nuntawat168/MOMIU-Embedded-System/README.md

# MOMIU-Embedded-System
This source is a embedded system part of Momiu robot project
https://ieeexplore.ieee.org/document/9795546/metrics#metrics
