nuntawat168/MOMIU-Embedded-System/! IMPORTANT - Release Document for Altium Designer.txt

Follow this procedure before releasing files. Confirm every action with your initials and date.
IF ANY CHANGES NEEDS TO BE DONE, START THE PROCEDURE FROM BEGINNING!

The procedure needs to be executed in order as defined here. Start from number 1
--------------------------------------------------------------------------------

1) Right Click on the project -> Compile PCB project
I confirm, the project compiles with no errors: 
Confirm [23-04-2021]

2) Run Design -> Update PCB Document
I confirm, there are no differences between Schematic and PCB: 
Confirm [23-04-2021]

3) Impedance
I confirm, I have updated and check track width/gap to match required impedance (e.g 55 OHMs): 
NA

4) Run Tools -> Polygon Pours -> Rebuild All
I confirm, all polygons have been repoured: 
Confirm [23-04-2021]

5) Run Tools -> Design Rule Check -> Run Design Rule Check
I confirm, I have checked Design Rule Output File:
Confirm [23-04-2021]

6) Gerber check
I confirm, I have copied and visually checked gerber files placed in \PCB Manufacturing\Gerber Output\
Confirm [23-04-2021]

7) Other files
I confirm, I have copied and checked files placed in subdirectories:
Confirm [23-04-2021]
