nuntawat168/MOMIU-Embedded-System/6 - Source Files/Media/Image-3D_PCB-INTERFACE-BOARD-MOMIU.png

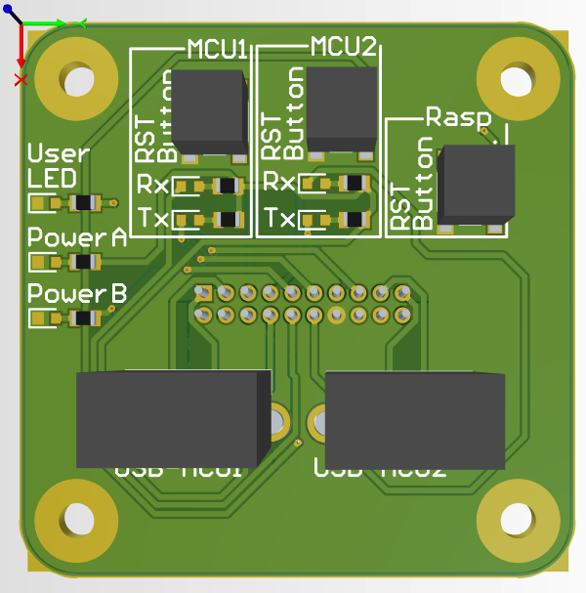
6 - Source Files/Media/Image-3D_PCB-INTERFACE-BOARD-MOMIU.png
