nuntawat168/MOMIU-Embedded-System/2 - Board Assembly/BOM Purchase_MOMIU-Circuit.xlsx

Sheet: Part List Report
 | Bil of Materials |  |  | BOM MOMIU Robot Circuit
 | Source Data From: | momiu_01.PrjPcb
 | Project: | momiu_01.PrjPcb
 | Variant: | None
 | Report Date: | 5/7/2021 | 9:30 PM
 | Print Date: | 2021-05-08 | 9:22:43
No. | Component | Description | Designator | Supplier | Quantity | Supplier Order Qty | Supplier Unit Price | Supplier Ext. Price | Supplier Currency | Supplier Stock | Supplier Part Number 1 | PhysicalPath | Mouser Price/Stock
1 | 20SVPF120M | Capacitor Polarised | C1, C3 | Mouser | 2 | 2 | 1.25 | 2.5 | USD | 14231 | 667-20SVPF120M | MAIN BOARD | https://www.mouser.co.uk/ProductDetail/Panasonic/20SVPF120M/?qs=OE1iw1LrrPFAGQZp2uLmXQ%3D%3D
2 | *EMVY160ADA471MHA0G | Capacitor Polarised | C2, C4 | Mouser | 2 | 2 | 0.7 | 1.4 | USD | 0 | 661-EMVY160ADA471MHA | MAIN BOARD | https://www.mouser.com/Search/Refine.aspx?Keyword=661-EMVY160ADA471MHA
 | **UWT1C471MNL1GS | Capacitor Polarised | C2, C5 | E-SOURCE | 2 | 2 | 0.17 | 0.34 | USD | 9,117 | 0289-0172-4 | MAIN BOARD | https://www.es.co.th/detail.asp?Prod=028901724
4 | C0805C104K5RAC7411 | Capacitor | C5, C6 | Mouser | 2 | 2 | 0.24 | 0.48 | USD | 32058 | 80-C0805C104K5RACLR | MAIN BOARD | https://www.mouser.co.uk/ProductDetail/KEMET/C0805C104K5RAC7411?qs=jbRM9o5BbzPcVXF0wW9AYg%3D%3D
5 | *PDS560-13 | Diode | D1, D2 | Mouser | 2 |  | 1.05 | 0 | USD | 0 | 621-PDS560-F | MAIN BOARD | https://www.mouser.co.uk/ProductDetail/Diodes-Incorporated/PDS560-13?qs=%2FNF5U5UGuWkl3I91y%252BsKBg%3D%3D
 | **PDS760-13 | Diode | D1, D2 | Mouser | 2 | 2 | 1.02 | 2.04 | USD | 48658 | 621-PDS760-F | MAIN BOARD | https://www.mouser.com/ProductDetail/Diodes-Incorporated/PDS760-13
7 | MMZ2012R600AT000 | Ferrite Beads 60 OHM 25% @100 MHz | FB1, FB2, FB3, FB4, FB5, FB6, FB7, FB8, FB9, FB10, FB11, FB12 | Mouser | 12 | 12 | 0.053 | 0.636 | USD | 18028 | 810-MMZ2012R600AT000 | INTERFACE BOARD, MAIN BOARD | https://www.mouser.com/ProductDetail/TDK/MMZ2012R600AT000
8 | LM2576HVS-5.0 | Integrated Circuit | IC1, IC2 | Mouser | 2 |  | 6.96 | 0 | USD | 3128 | 926-LM2576HVS5.0NOPB | MAIN BOARD | https://www.mouser.co.uk/ProductDetail/Texas-Instruments/LM2576HVS-50/?qs=X1J7HmVL2ZGtvFS7GBfMMQ%3D%3D
 | LM2576HVR-5.0 | Integrated Circuit | IC1, IC3 | E-SOURCE | 2 | 2 | 1.21 | 2.42 | USD | 59 | 0339-0011-4 | MAIN BOARD | https://www.es.co.th/detail.asp?Prod=033900114
10 | 22-03-5035 | Connector | J2, J3, J4, J5, J6, J7 | Mouser | 6 | 6 | 0.24 | 1.44 | USD | 18151 | 538-22-03-5035 | MAIN BOARD | https://www.mouser.co.uk/ProductDetail/Molex/22-03-5035?qs=VKrXD49J9Ep%252Bv2WwbOoiPA%3D%3D
11 | 22035045 | Connector | J8, J10, J11, J13, J20, J21 | Mouser | 6 | 6 | 0.26 | 1.56 | USD | 3587 | 538-22-03-5045 | MAIN BOARD | https://www.mouser.com/ProductDetail/Molex/22-03-5045
12 | PRT-14275 | Connector | J9 | Mouser | 1 | 1 | 0.95 | 0.95 | USD | 14 | 474-PRT-14275 | MAIN BOARD | https://www.mouser.co.uk/ProductDetail/SparkFun/PRT-14275/?qs=YCa%2FAAYMW01SLG%2FRsDUFug%3D%3D
13 | 87583-3010RPALF | Connector | J12, J14, J15 | Mouser | 3 | 3 | 0.94 | 2.82 | USD | 1604 | 649-87583-3010RPALF | MAIN BOARD | https://www.mouser.co.uk/ProductDetail/Amphenol-FCI/87583-3010RPALF/?qs=nBv%252BRDKgYU12SV7JkWVR7Q%3D%3D
14 | 957220-6002-AR | Connector | J16, J17 | Mouser | 2 |  | 2.66 | 0 | USD | 4778 | 517-957220-6002-AR | MAIN BOARD, INTERFACE BOARD | https://www.mouser.co.uk/ProductDetail/3M-Electronic-Solutions-Division/957220-6002-AR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
15 | GSB11121KEU | Connector | J18, J19 | Mouser | 2 | 2 | 0.7 | 1.4 | USD | 1676 | 523-GSB11121KEU | INTERFACE BOARD | https://www.mouser.com/ProductDetail/Amphenol-Commercial-Products/GSB11121KEU
16 | 22-03-5075 | Connector | J22, J23, J24, J25, J26 | Mouser | 5 | 5 | 0.35 | 1.75 | USD | 4330 | 538-22-03-5075 | MAIN BOARD | https://www.mouser.co.uk/ProductDetail/Molex/22-03-5075?qs=4hg9R9g9MDvXfItj0edHKA%3D%3D
17 | SRP2313AA-101M | Inductor | L1, L2 | Mouser | 2 | 2 | 7.8 | 15.6 | USD | 447 | 652-SRP2313AA-330M | MAIN BOARD | https://www.mouser.co.uk/ProductDetail/Bourns/SRP2313AA-101M?qs=gZXFycFWdANfITbqx%252BPtOw%3D%3D
18 | SML-D12Y8WT86C | LED | LED1, LED4 | Mouser | 2 | 2 | 0.31 | 0.62 | USD | 28848 | 755-SML-D12Y8WT86 | INTERFACE BOARD | https://www.mouser.co.uk/ProductDetail/ROHM-Semiconductor/SML-D12Y8WT86C?qs=HXFqYaX1Q2zmWm4VzJ%252BtnA%3D%3D
19 | SML-D12M8WT86C | LED | LED2, LED3 | Mouser | 2 | 2 | 0.31 | 0.62 | USD | 22557 | 755-SML-D12M8WT86 | INTERFACE BOARD | https://www.mouser.co.uk/ProductDetail/ROHM-Semiconductor/SML-D12M8WT86C?qs=HXFqYaX1Q2wmk6UmYQ4EIQ%3D%3D
20 | SML-D12U1WT86 | LED | LED5, LED6, LED7 | Mouser | 3 | 3 | 0.2 | 0.6 | USD | 183969 | 755-SML-D12U1WT86 | INTERFACE BOARD | https://www.mouser.co.uk/ProductDetail/ROHM-Semiconductor/SML-D12U1WT86?qs=M3jcYzEJUdEySuGkbjHEtQ%3D%3D
21 | CRCW080510K0JNEAC | Resistor | R1 | Mouser | 1 | 1 | 0.1 | 0.1 | USD | 76591 | 71-CRCW0805J-10K-E3 | MAIN BOARD | https://www.mouser.co.uk/ProductDetail/Vishay-Dale/CRCW080510K0JNEAC?qs=E3Y5ESvWgWO0MOXy5ngfMA%3D%3D
22 | CHP0805AFX-5600ELF | Resistor | R2, R3, R4, R5, R6, R7, R8 | Mouser | 7 | 7 | 0.47 | 3.29 | USD | 2315 | 652-CHP0805AFX-5600L | INTERFACE BOARD | https://www.mouser.co.uk/ProductDetail/Bourns/CHP0805AFX-5600ELF/?qs=GedFDFLaBXHiLkJv9wkGiw%3D%3D
23 | PTS645SK50JSMTR92_LFS | Switch | S1, S2, S3 | Mouser | 3 | 3 | 0.41 | 1.23 | USD | 17087 | 611-SK50JSMTR92LFS | INTERFACE BOARD | https://www.mouser.com/ProductDetail/CK/PTS645SK50JSMTR92-LFS
24 | SN74LS241N | Integrated Circuit | U1 | Mouser | 1 | 1 | 0.9 | 0.9 | USD | 809 | 595-SN74LS241N | MAIN BOARD | https://www.mouser.co.uk/ProductDetail/Texas-Instruments/SN74LS241N?qs=tJ5HNKWh3OV6ot2H0B4Gfg%3D%3D
25 | NUCLEO-F411RE | Microcomtroller | U2, U3 | Mouser | 2 |  | 13.55 | 0 | USD | 544 | 511-NUCLEO-F411RE | MAIN BOARD | https://www.mouser.com/ProductDetail/STMicroelectronics/NUCLEO-F411RE
26 | XT60-YELLOW | Power connector | J1 | Mouser | 1 | 2 | 1.5 | 3 | USD | 1006 | 474-PRT-10474 | MAIN BOARD | https://www.mouser.com/ProductDetail/SparkFun/PRT-10474?qs=WyAARYrbSnYJaRDMiD9g2w%3D%3D
24 | 50-37-5033 | Connector | None | Mouser | 6 | 6 | 0.34 | 2.04 | USD | 36349 | 538-50-37-5033 | None | https://www.mouser.com/ProductDetail/Molex/50-37-5033
25 | 50-37-5043 | Connector | None | Mouser | 6 | 6 | 0.37 | 2.22 | USD | 28900 | 538-50-37-5043 | None | https://www.mouser.com/ProductDetail/Molex/50-37-5043
26 | 50-37-5073 | Connector | None | Mouser | 5 | 5 | 0.2 | 1 | USD | 26658 | 538-50-37-5073 | None | https://www.mouser.com/ProductDetail/Molex/50-37-5073
27 | 08-70-1039 | Receptacle terminal | None | Mouser | 17 | 100 | 0.057 | 5.7 | USD | 6700 | 538-08-70-1039 | None | https://www.mouser.com/ProductDetail/Molex/08-70-1039-Cut-Strip?qs=Y0K5pK5Q%2FZG5wb5AnQMF0g%3D%3D
 |  |  |  |  |  |  |  | 56.656
Approved |  |  |  | Notes
 |  |  |  |  |  |  | 1 |  | pcs: | Total | 56.656 | USD
 |  |  |  |  |  |  |  |  |  | Price for 1pcs | 56.66 | USD

Sheet: Project Information
Project Full Path | D:\For Work\work year 4\year 4 term 1\thesis\Altium_ws\momiu_circuit_design\momiu_01\momiu_01.PrjPcb
Project Filename | momiu_01.PrjPcb
Variant Name | None
Data-Source Filename | momiu_01.PrjPcb
Data-Source Full Path | D:\For Work\work year 4\year 4 term 1\thesis\Altium_ws\momiu_circuit_design\momiu_01\momiu_01.PrjPcb
Title | BOM_MOMIU ROBOT-V1-PROJECT for Project [momiu_01.PrjPcb] (No PCB Document Selected)
Total Quantity | 71
Report Time | 9:30 PM
Report Date | 5/7/2021
Report Date & Tine | 5/7/2021 9:30 PM
Output Name | BOM_MOMIU ROBOT-V1-PROJECT
Output Type | BOM_PartType
Output Generator Name | BOM
Output Generator Description | Bill of Materials
