nuntawat168/MOMIU-Embedded-System/6 - Source Files/Templates/BOM Purchase_MOMIU-Ver.xlsx

Sheet: Part List Report
 | Bil of Materials |  |  | Field=Title
 | Source Data From: | Field=DataSourceFileName
 | Project: | Field=ProjectFileName
 | Variant: | Field=VariantName
 | Report Date: | Field=ReportDate | Field=ReportTime
 | Print Date: | 2021-05-07 | 21:28:43
# | Column=LibRef | Column=Description | Column=Designator | Column=Quantity | Column=Supplier 1 | Column=Supplier Unit Price 1 | Column=Supplier Currency 1 | Column=Supplier Stock 1 | Column=Supplier Packaging 1 | Column=Supplier Part Number 1 | Column=Mouser Price/Stock | Column=PhysicalPath | Column=Supplier Currency 1
1
2
3
 |  |  |  |  |  | 0 |  |  | 0 |  |  | 0
Approved |  |  |  | Notes
 |  |  |  |  |  | Field=ProductionQuantity | pcs: | Total |  | 0 |  | Field=Currency
 |  |  |  |  |  |  |  | Price for 1pcs |  | #VALUE! |  | Field=Currency

Sheet: Project Information
Project Full Path | Field=ProjectFullPath
Project Filename | Field=ProjectFileName
Variant Name | Field=VariantName
Data-Source Filename | Field=DataSourceFileName
Data-Source Full Path | Field=DataSourceFullPath
Title | Field=Title
Total Quantity | Field=TotalQuantity
Report Time | Field=ReportTime
Report Date | Field=ReportDate
Report Date & Tine | Field=ReportDateTime
Output Name | Field=OutputName
Output Type | Field=OutputType
Output Generator Name | Field=GeneratorName
Output Generator Description | Field=GeneratorDescription
