nuntawat168/MOMIU-Embedded-System/4 - 3D/3D-STEP_PCB_INTERFACE-BOARD-MOMIU.step

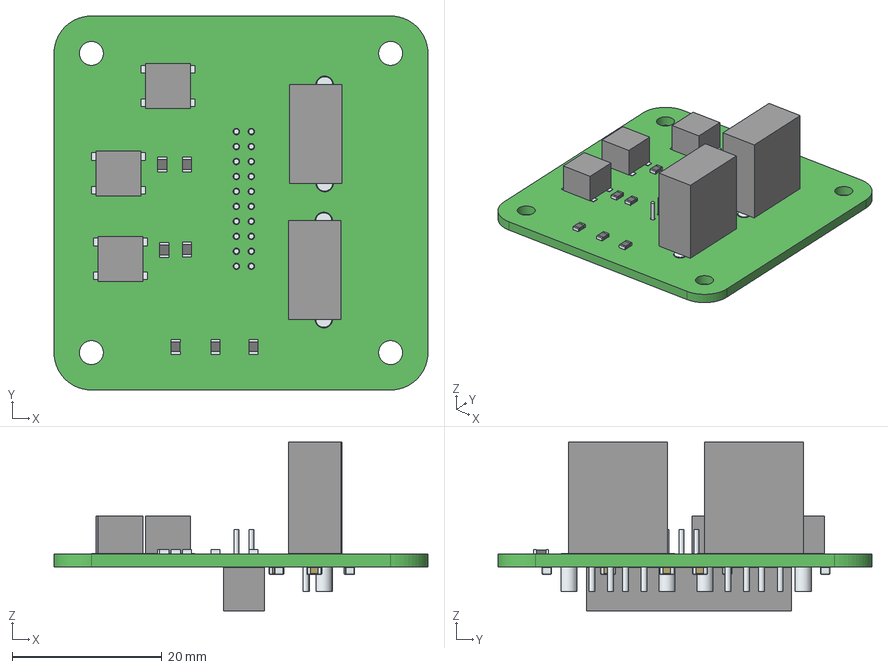
[picture p3: CAD file, 2021-12-10]
4 - 3D/3D-STEP_PCB_INTERFACE-BOARD-MOMIU.step
50.0 x 50.0 x 22.6 mm
term1 x 7
term2 x 7
Pins x 3
Leads x 32
