nuntawat168/MOMIU-Embedded-System/5 - Schematic/MOMIU ROBOT-V1_Schematic.PDF

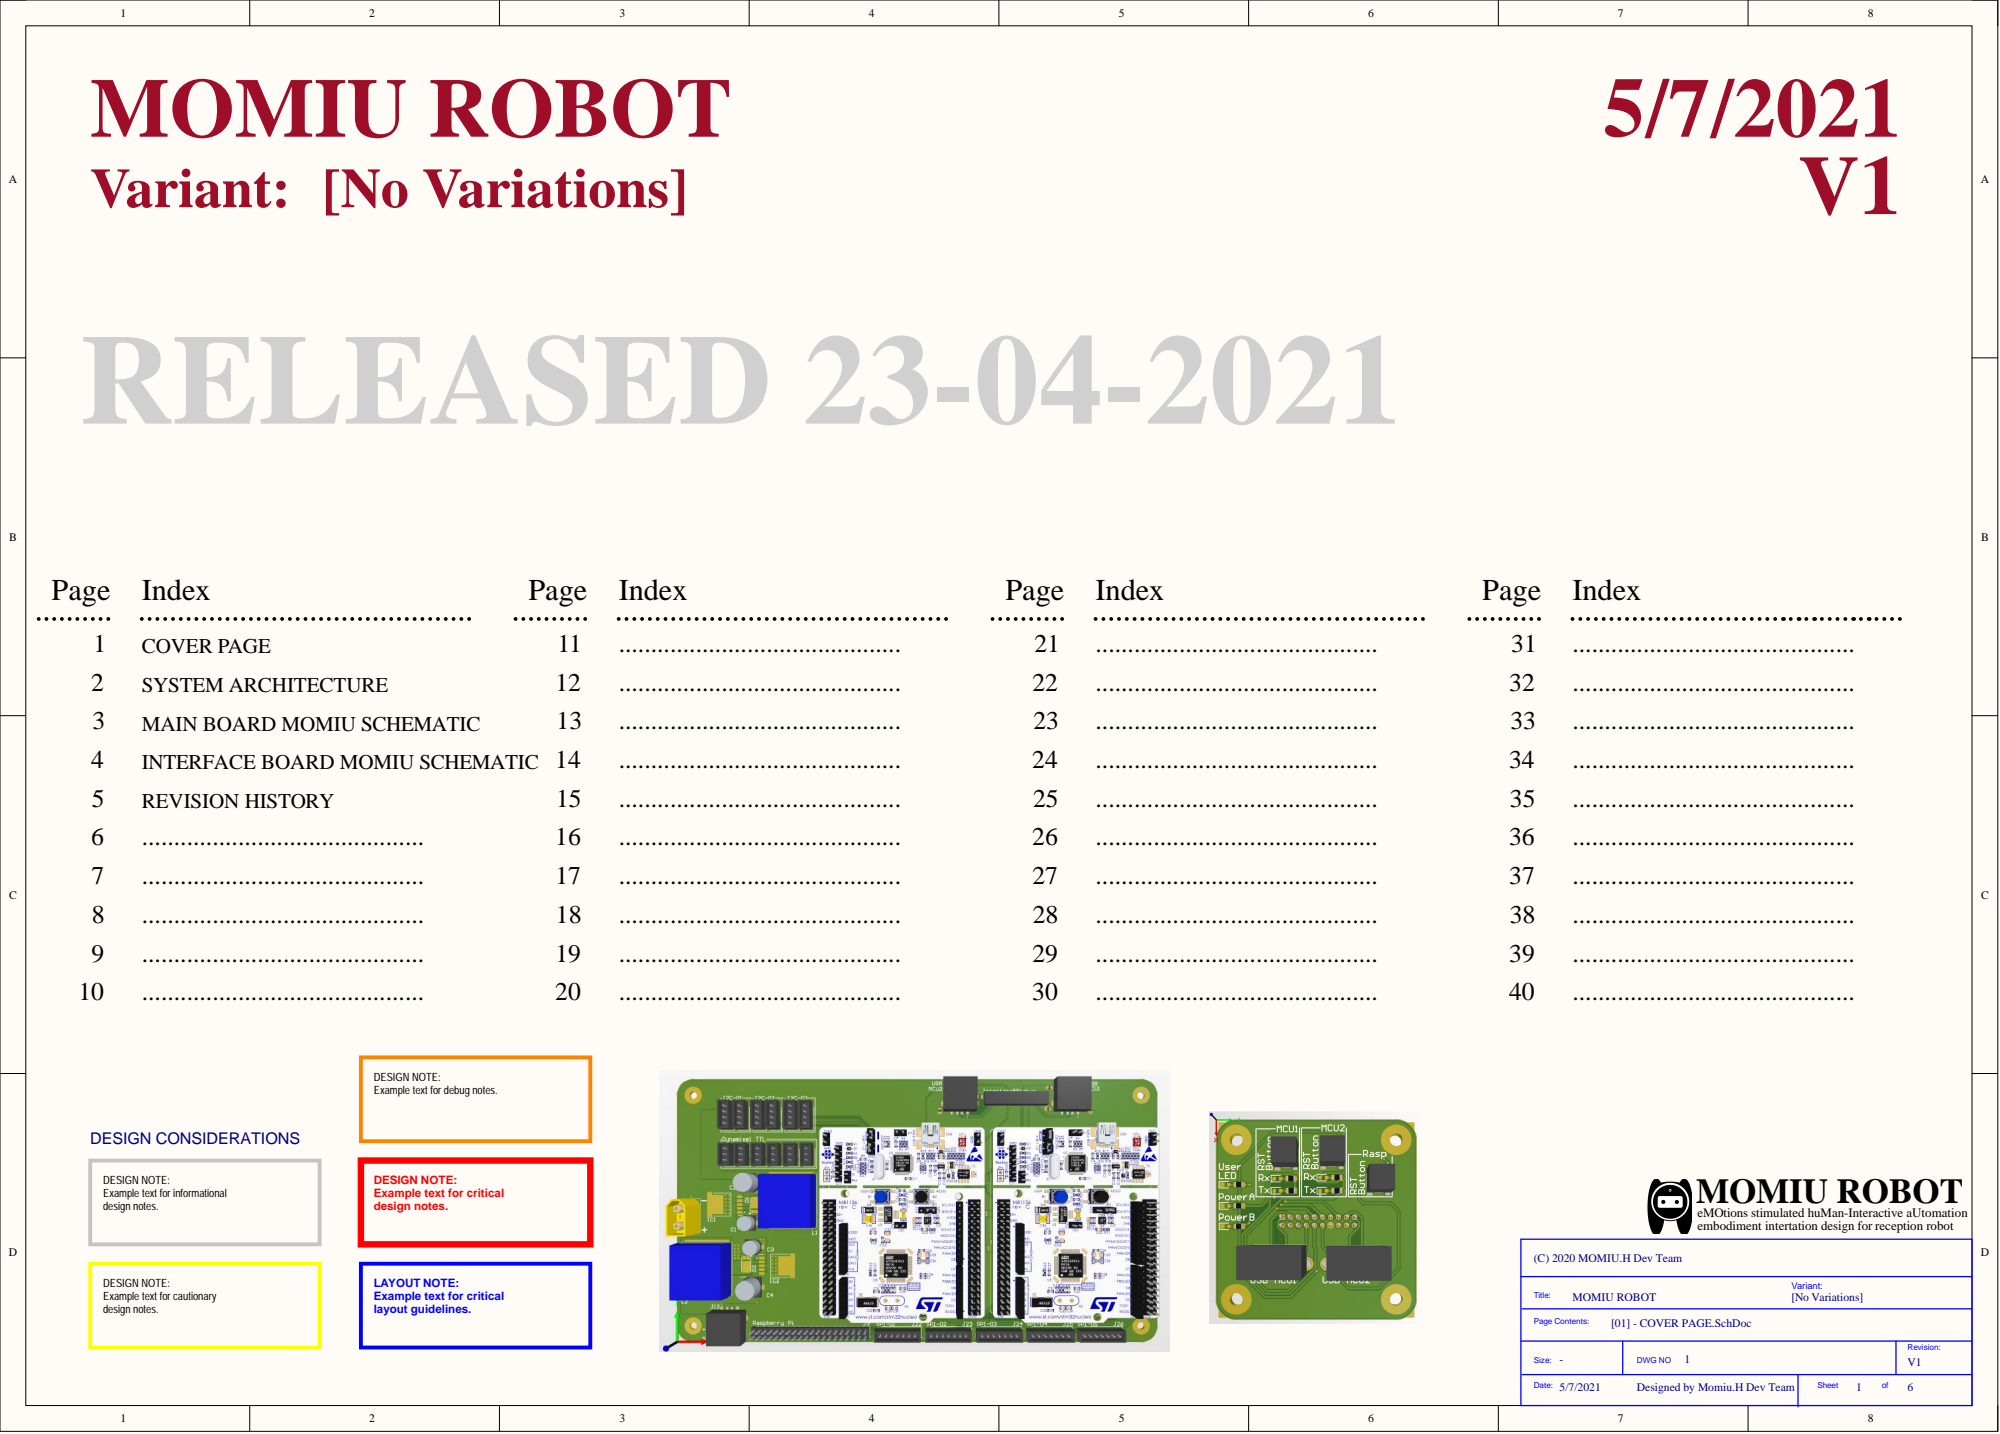
[picture p4: page 1]

DESIGN NOTE:
Example text for debug notes.

Example text for informational
design notes.

Example text for critical

eMOtions stimulated huMan-Interactive aUtomation
embodiment intertation design for reception robot

Example text for cautionary

LAYOUT NOTE:
layout guidelines.

Size: - 1 | DWG NO | Revision: V1

Date: Designed by Momiu.H Dev Team | Sheet of

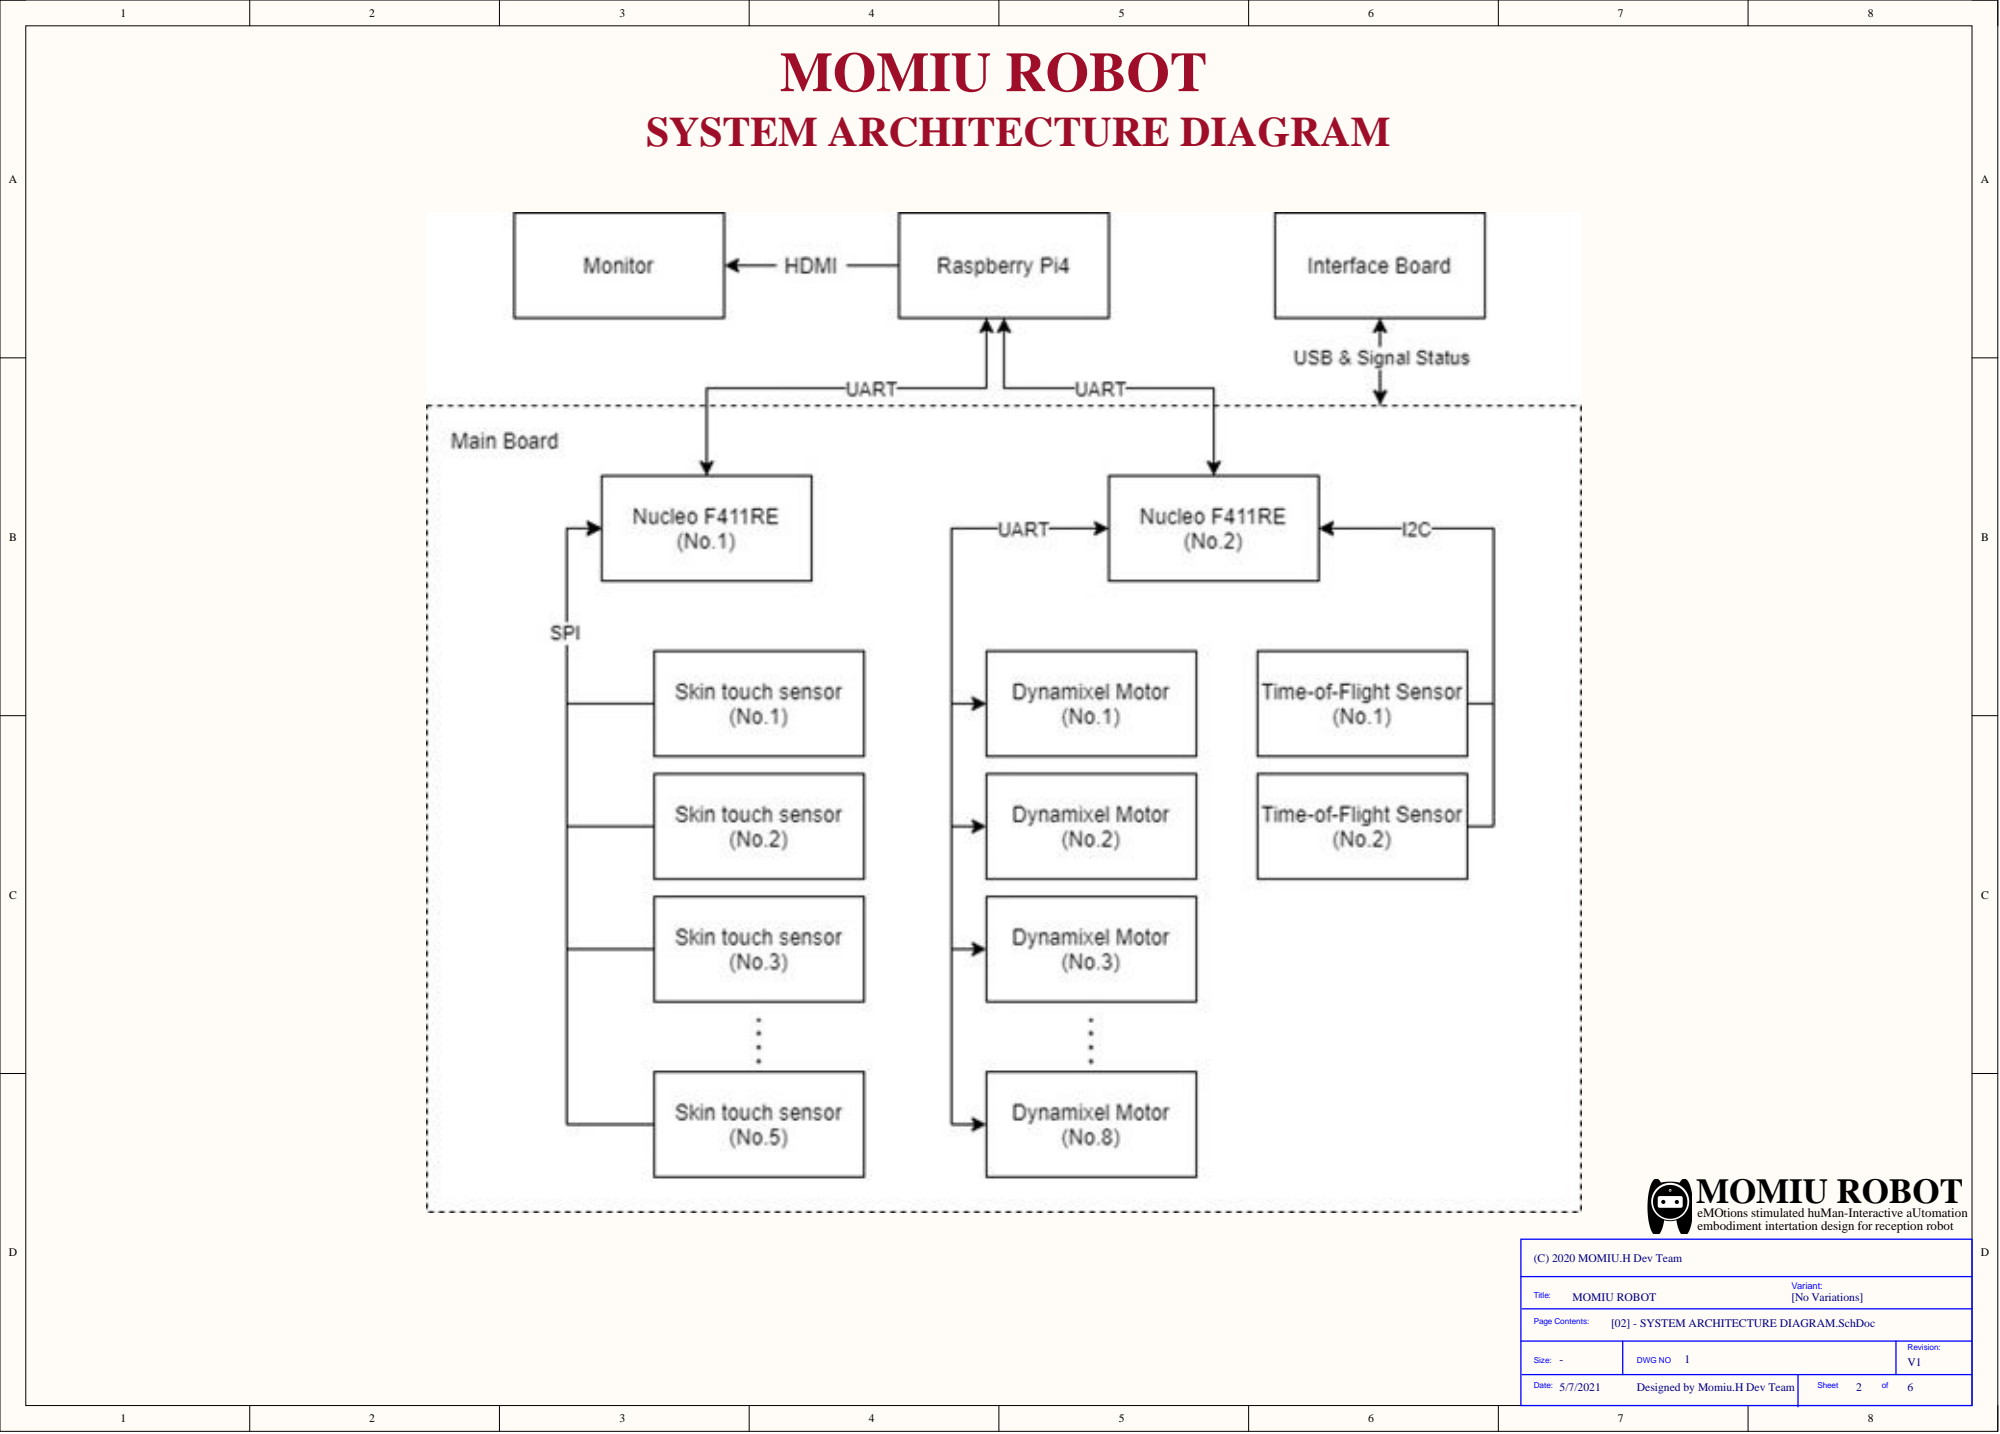
[picture p5: page 2]

eMOtions stimulated huMan-Interactive aUtomation
embodiment intertation design for reception robot

[02] - SYSTEM ARCHITECTURE DIAGRAM.SchDoc

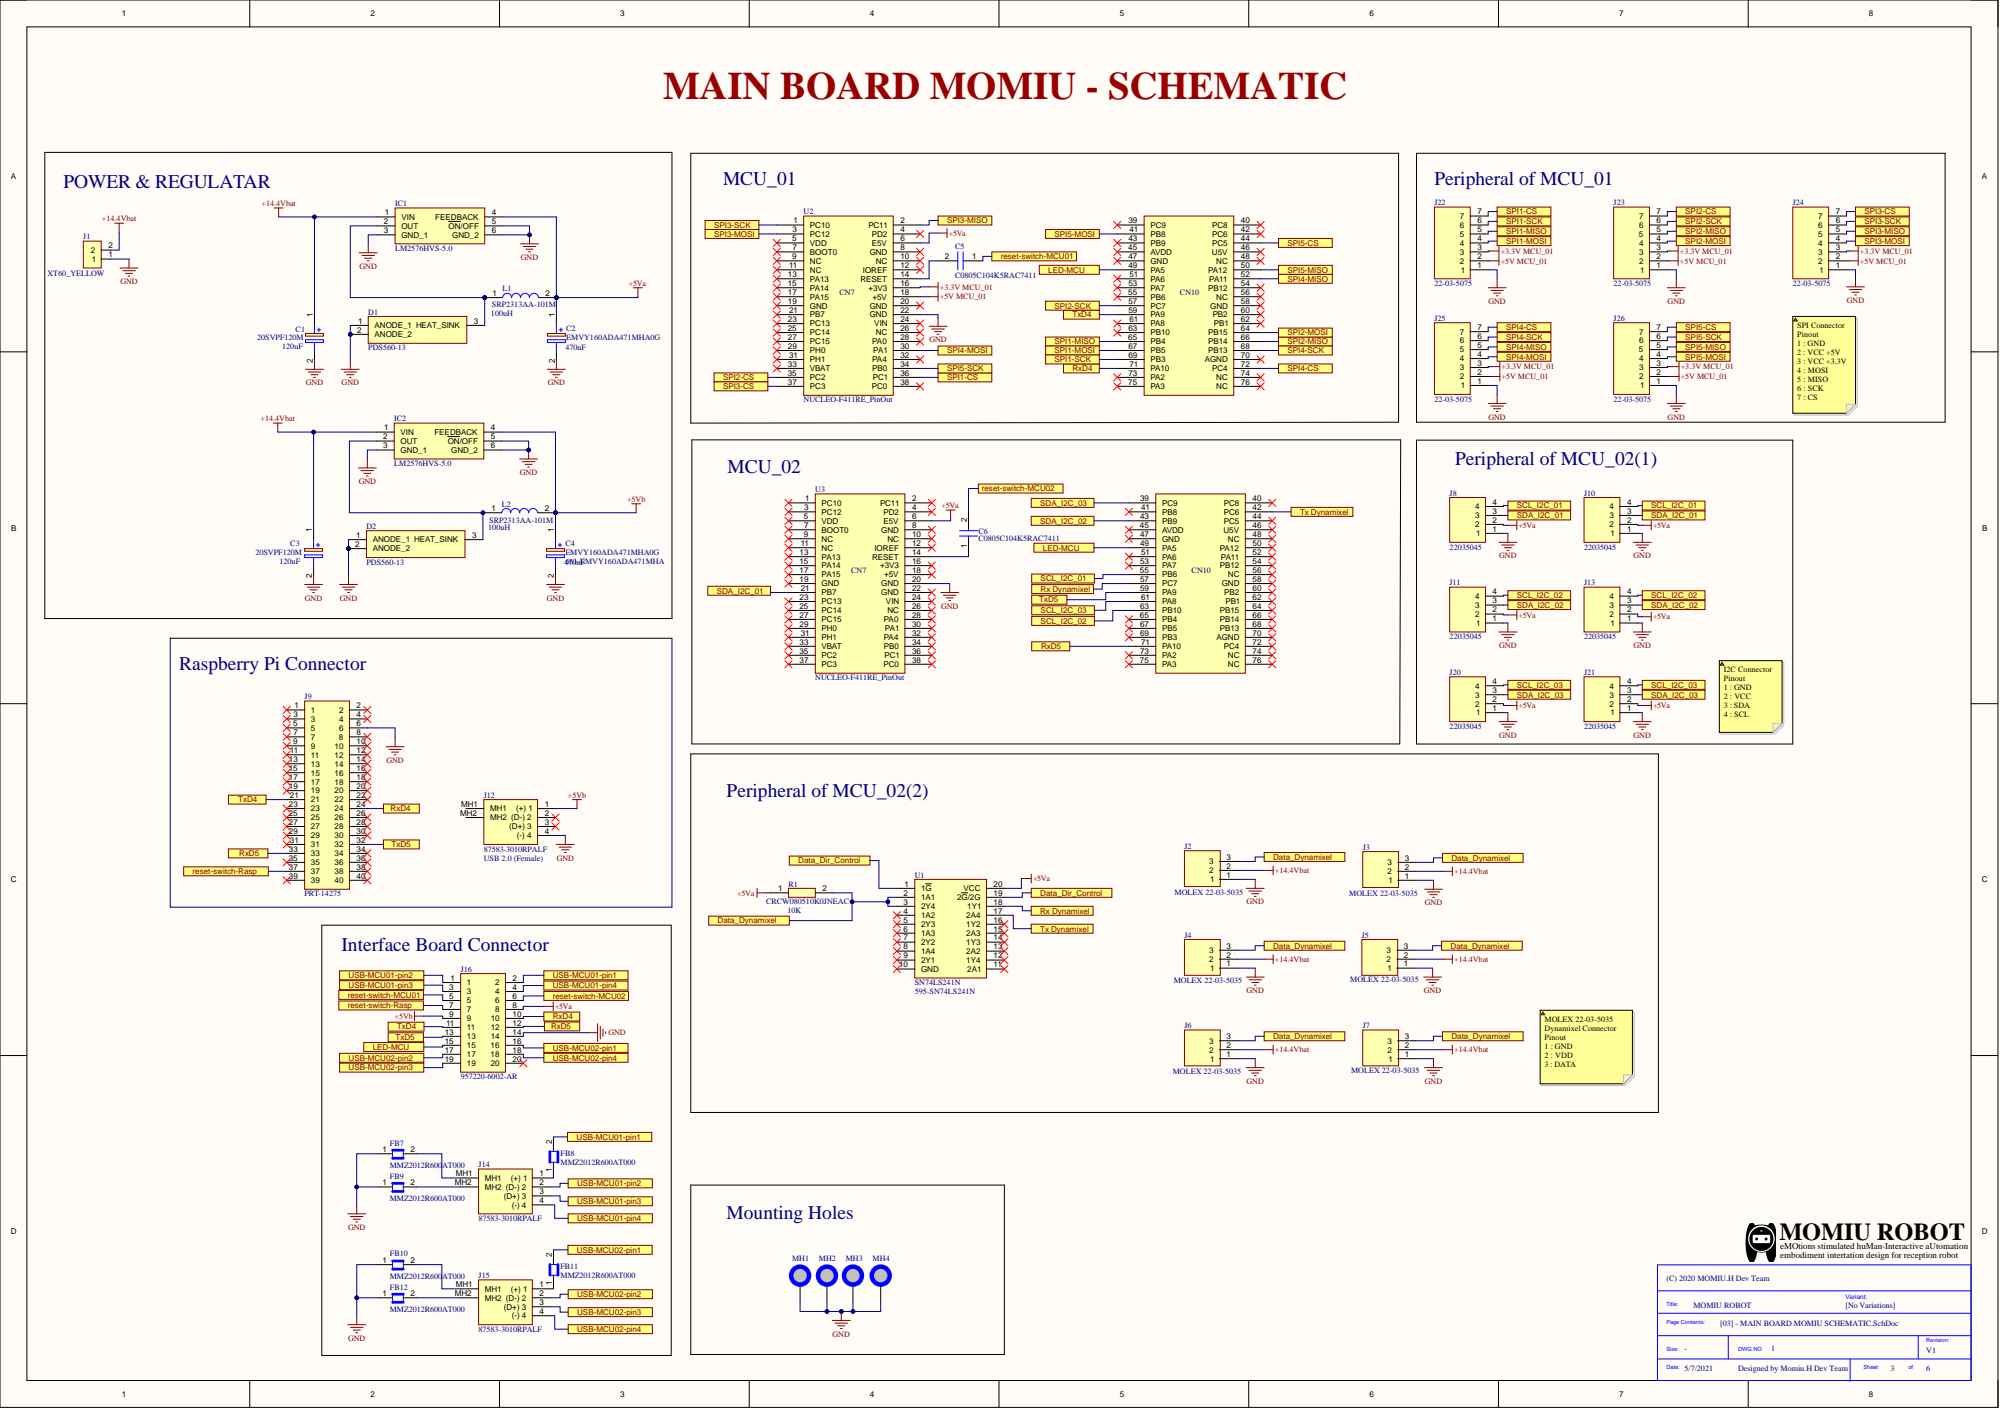
[picture p6: page 3]

MAIN BOARD MOMIU - SCHEMATIC

eMOtions stimulated huMan-Interactive aUtomation
embodiment intertation design for reception robot

[03] - MAIN BOARD MOMIU SCHEMATIC.SchDoc

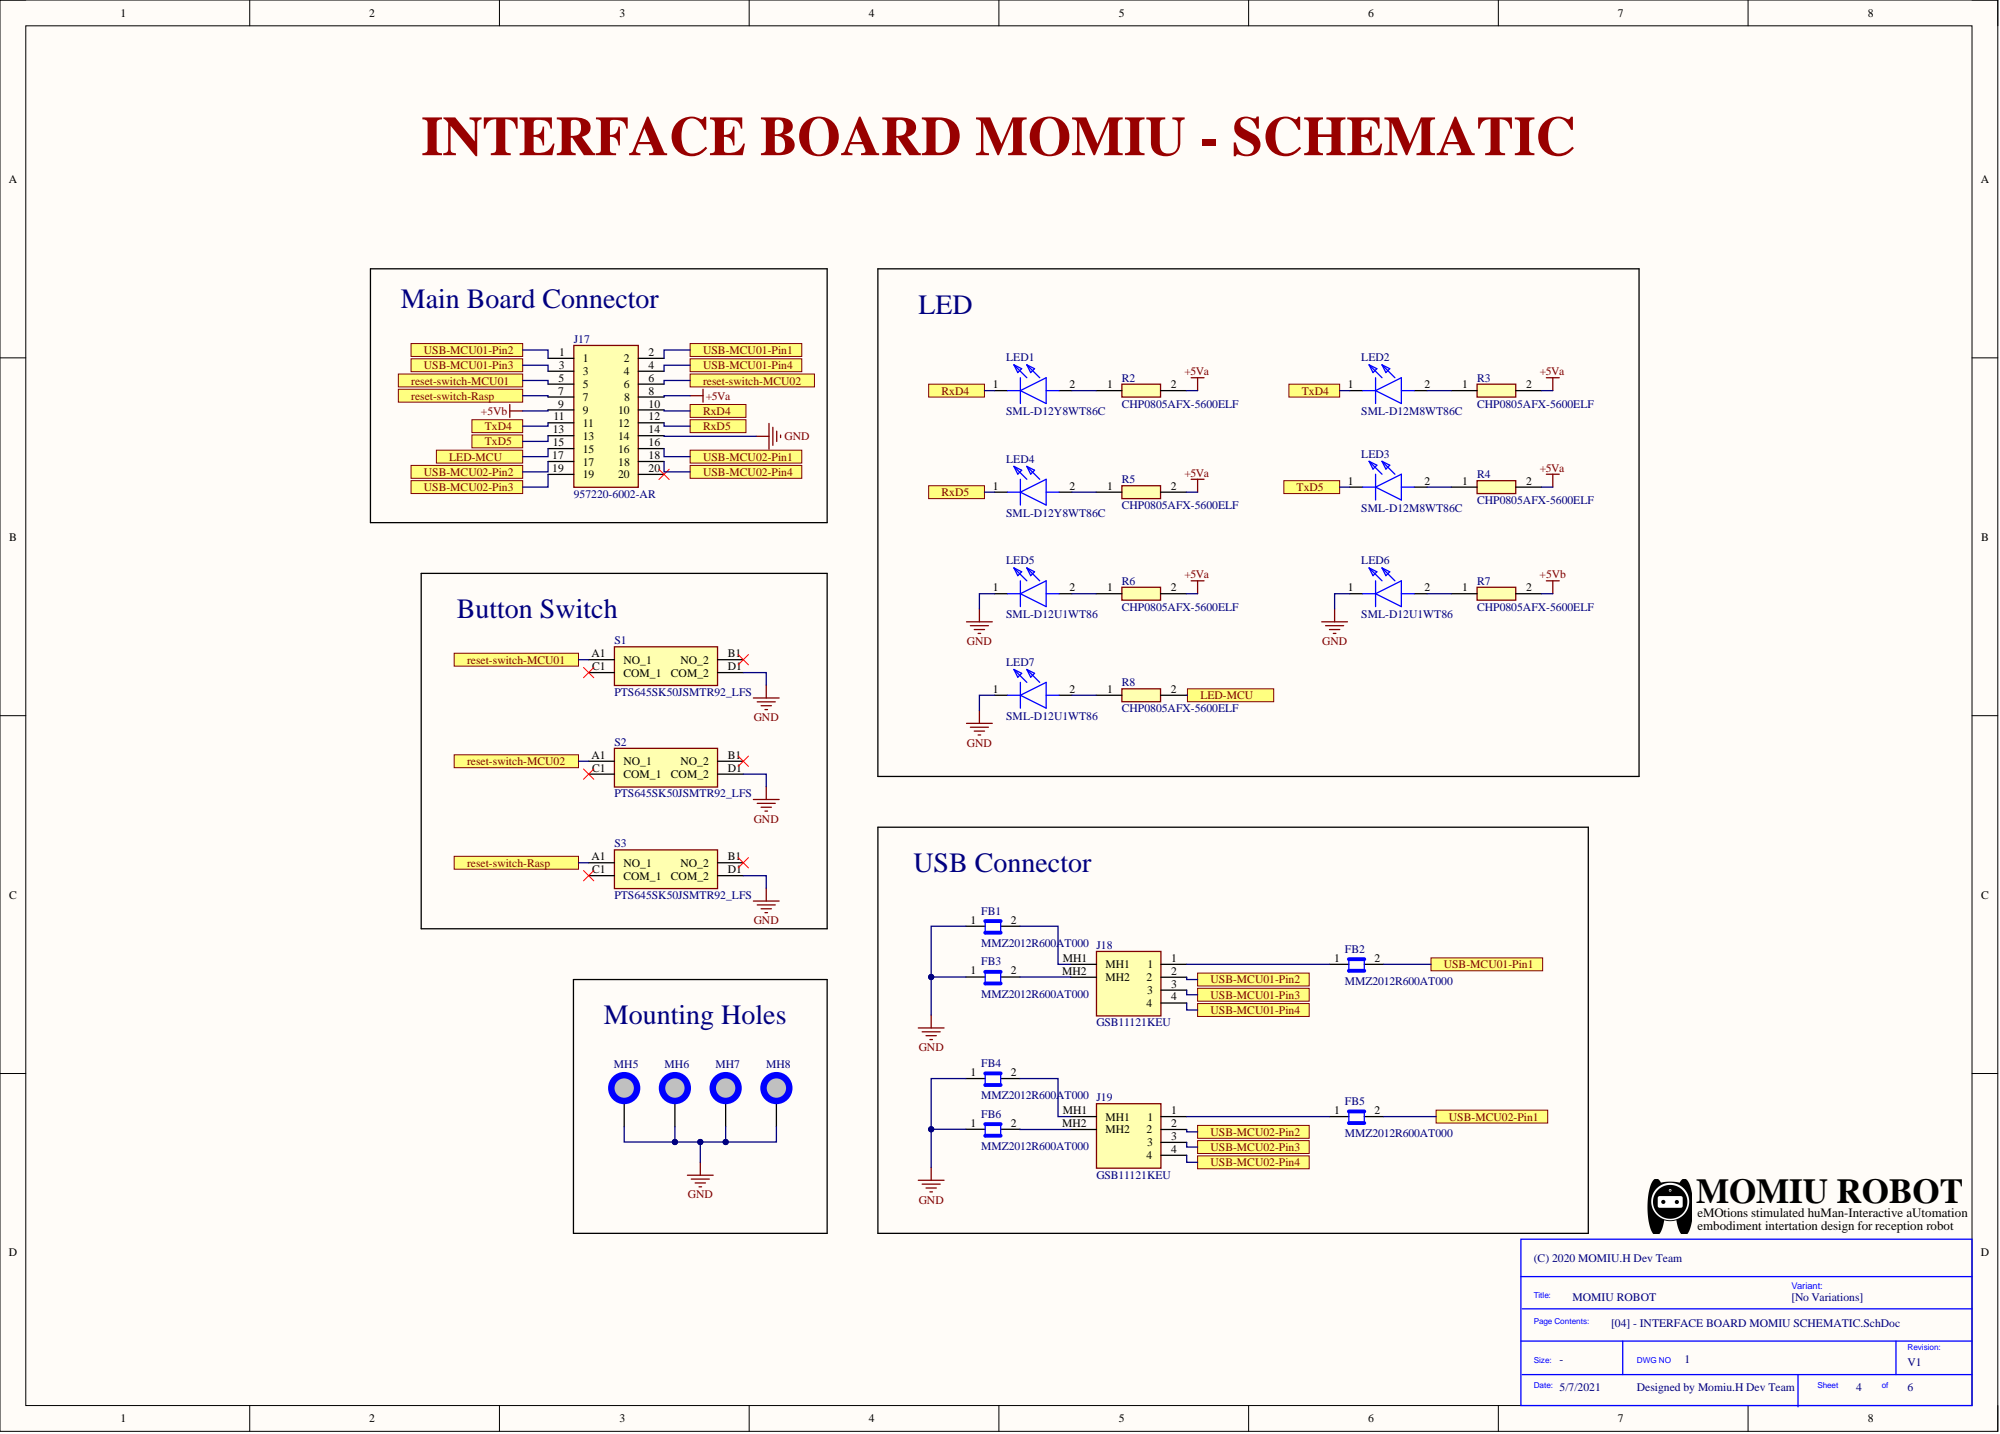
[picture p7: page 4]

INTERFACE BOARD MOMIU - SCHEMATIC

eMOtions stimulated huMan-Interactive aUtomation
embodiment intertation design for reception robot

[04] - INTERFACE BOARD MOMIU SCHEMATIC.SchDoc

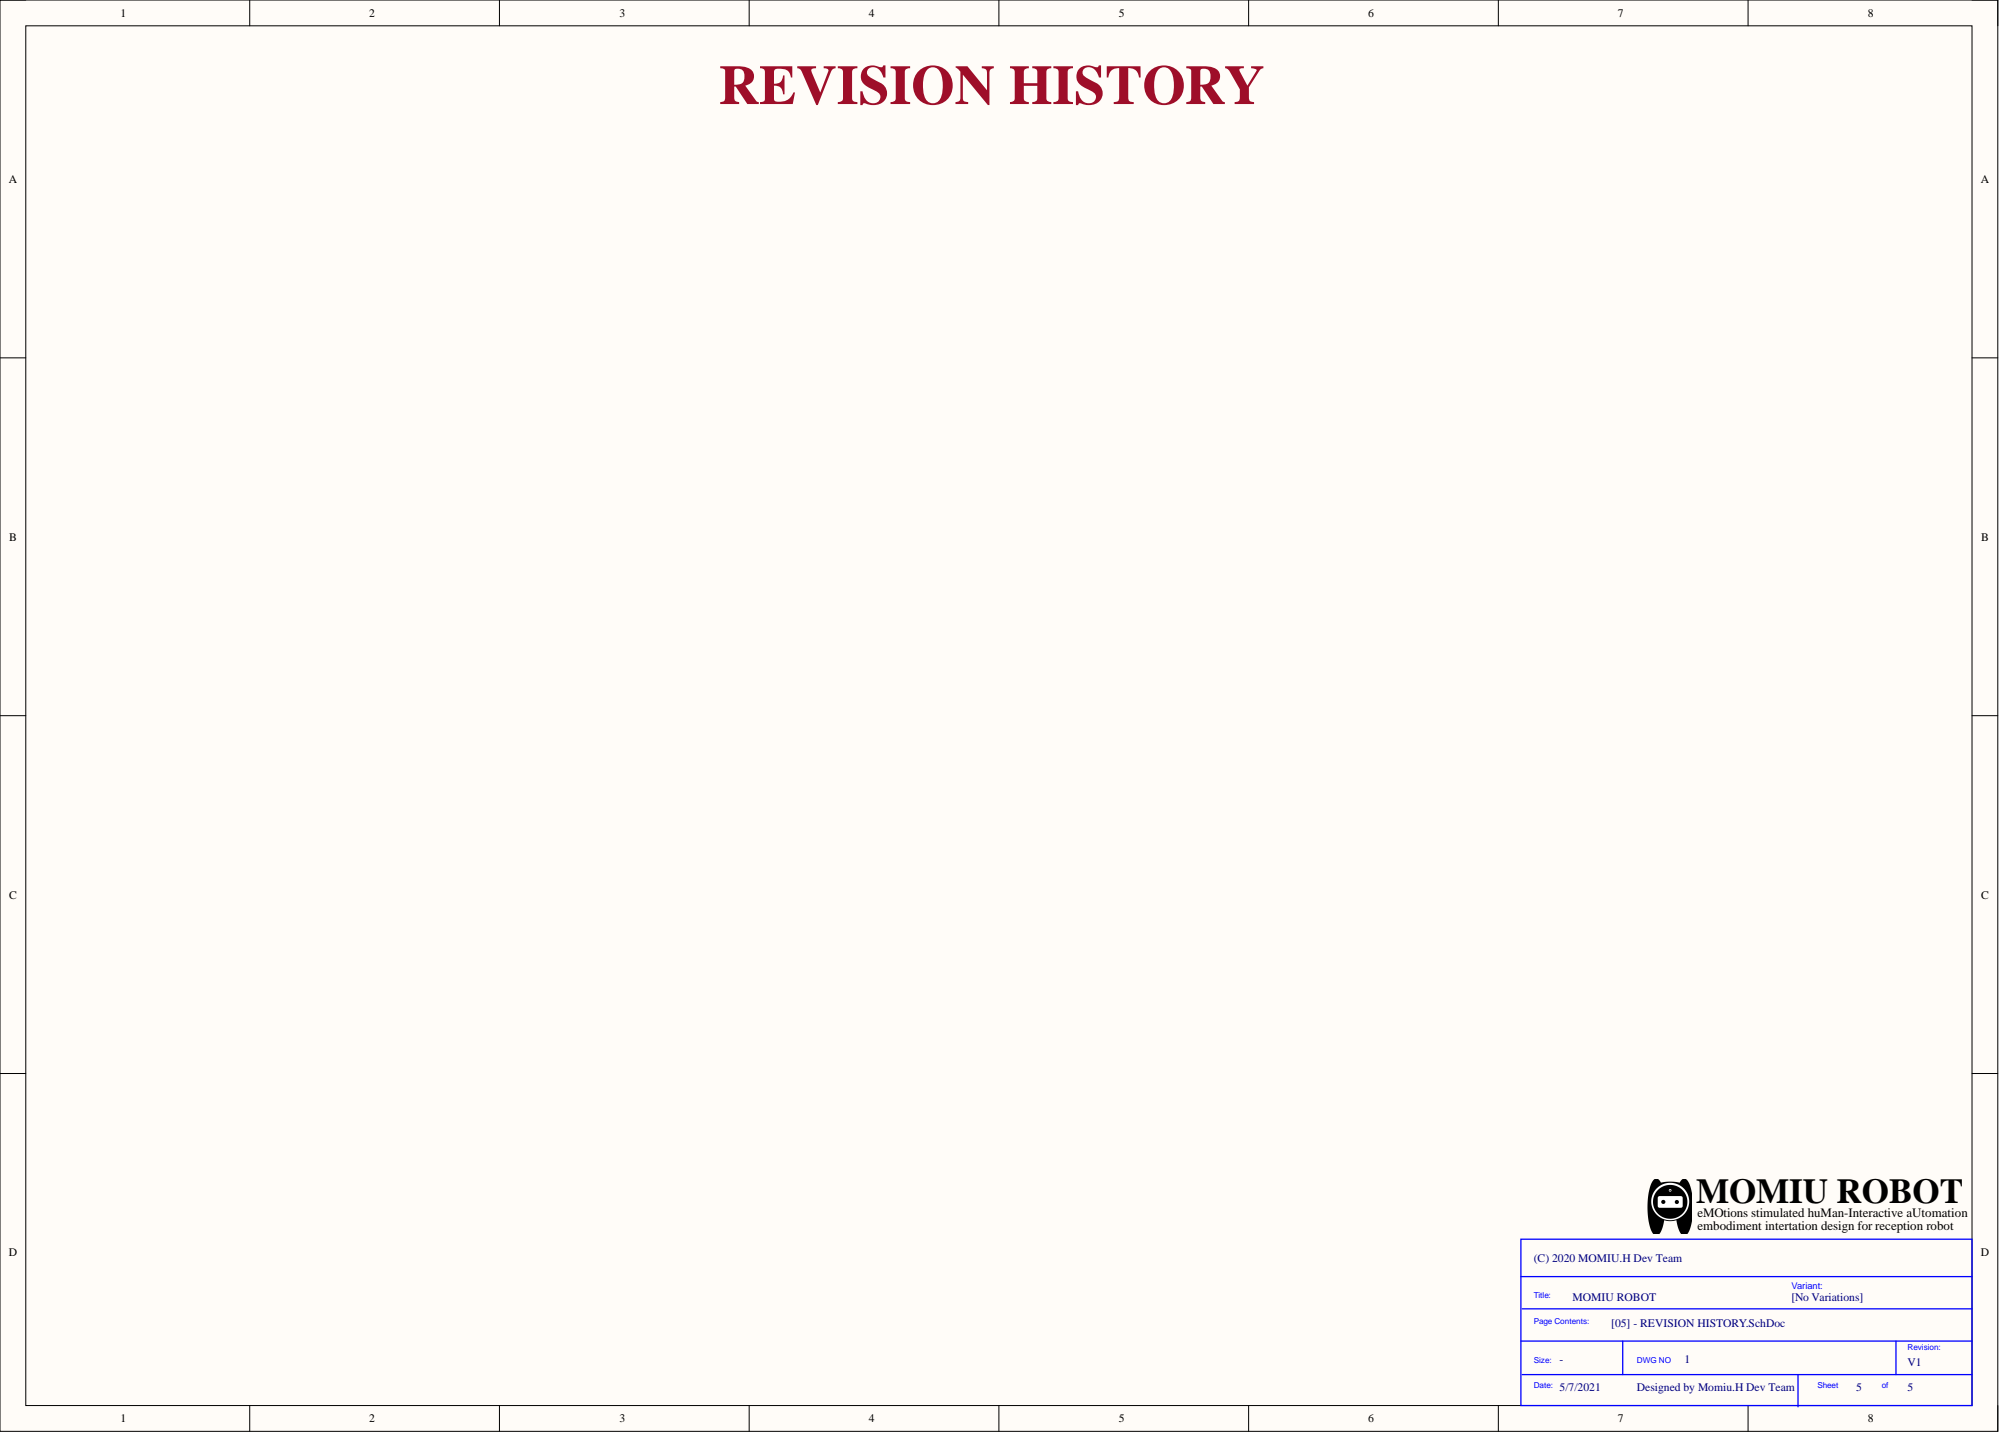
[picture p8: page 5]

eMOtions stimulated huMan-Interactive aUtomation
embodiment intertation design for reception robot

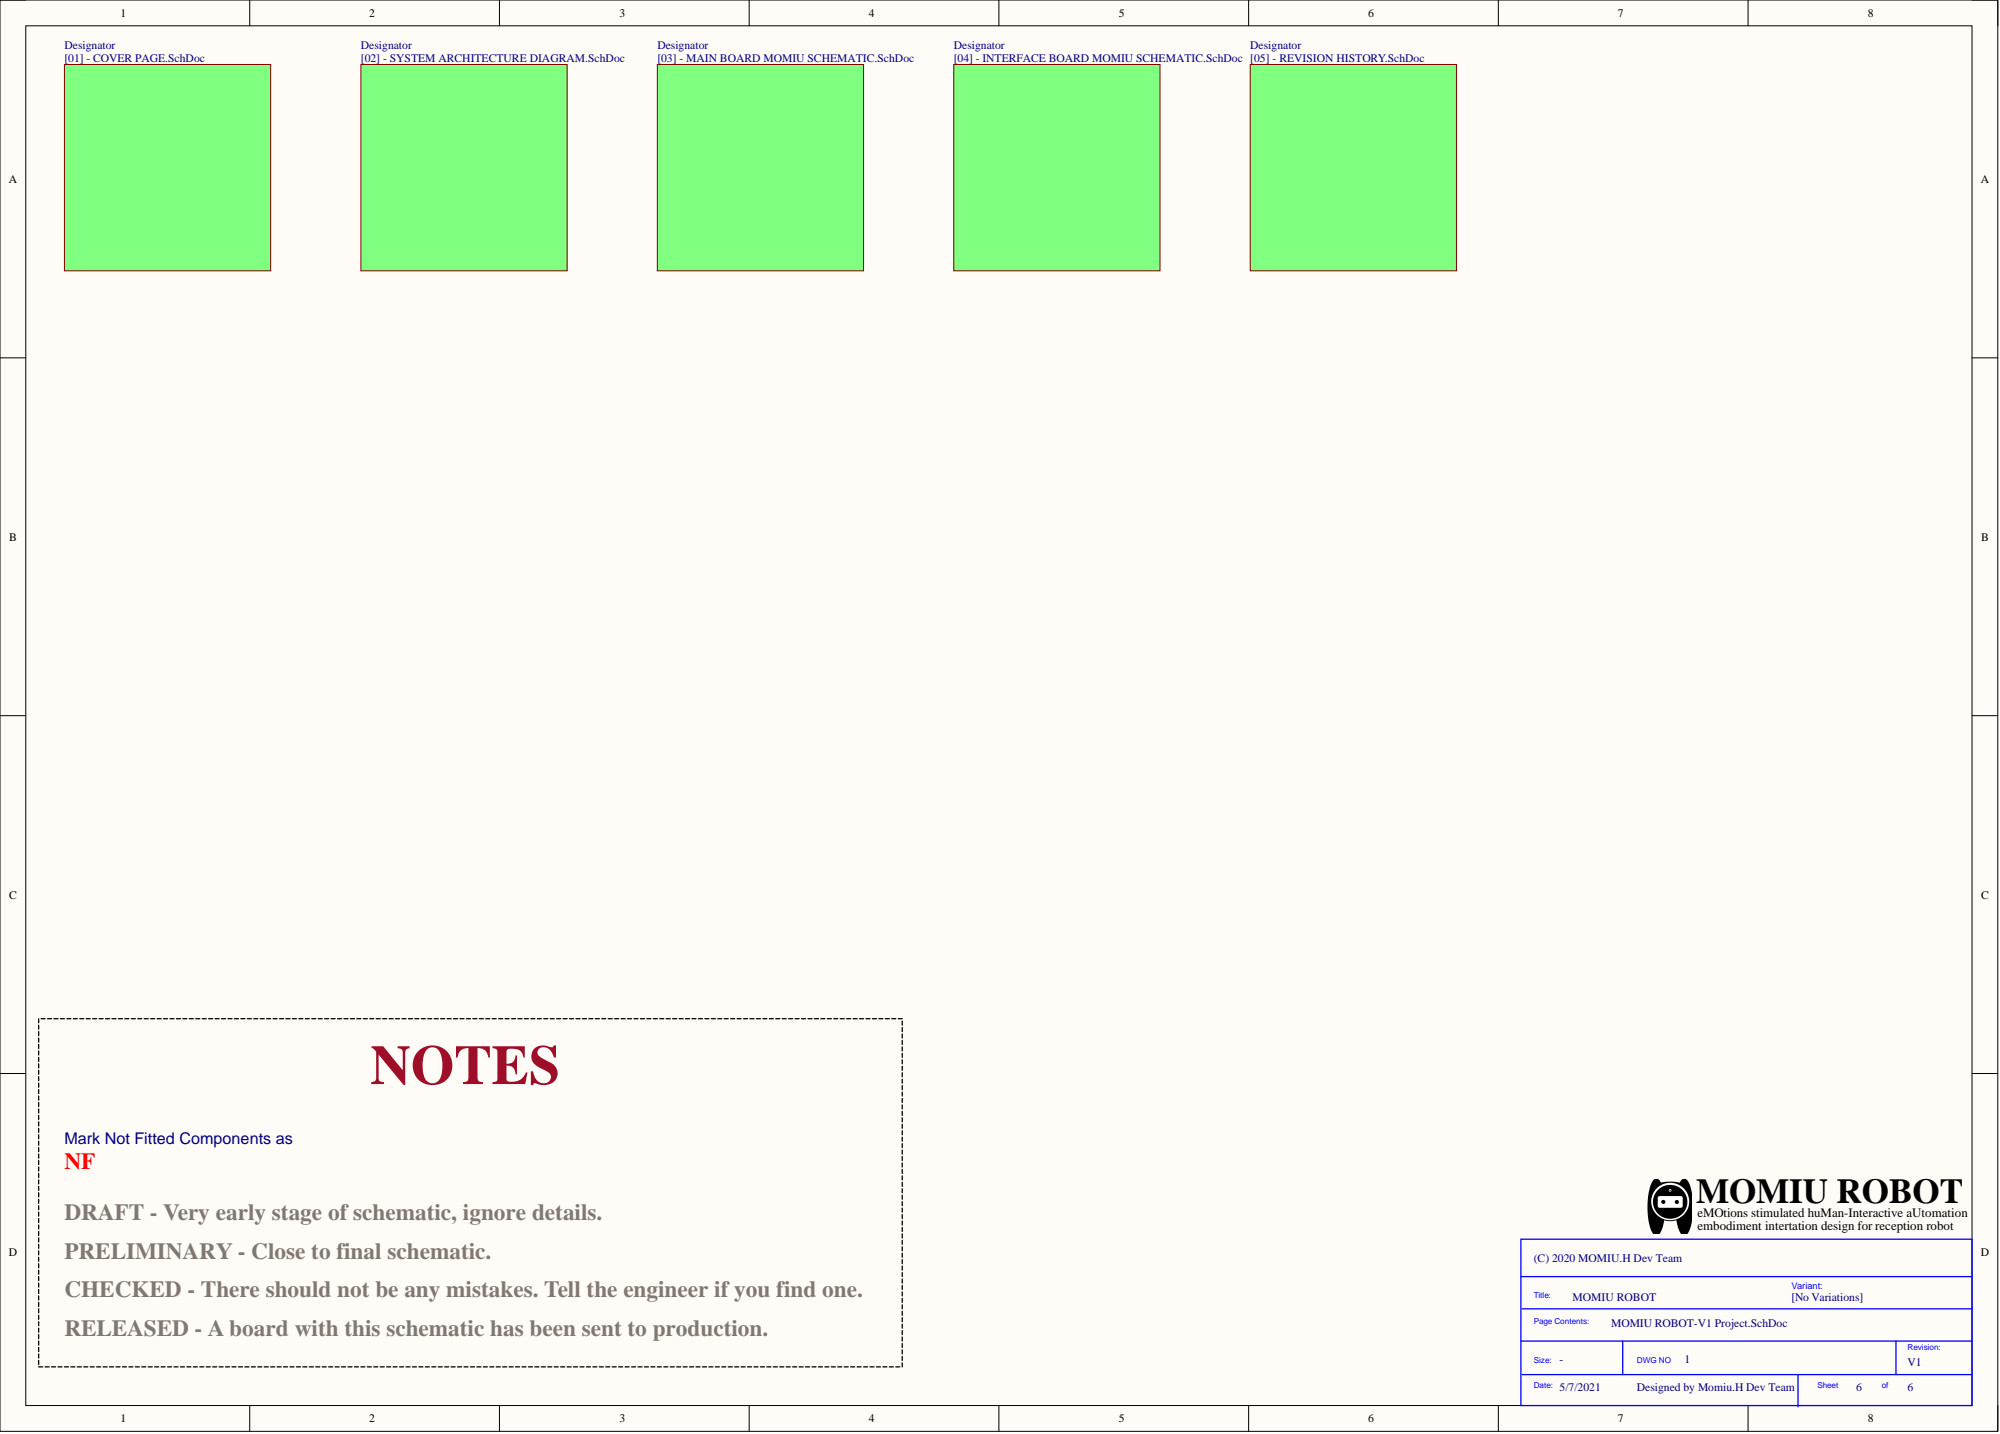
[picture p9: page 6]

Designator
[02] - SYSTEM ARCHITECTURE DIAGRAM.SchDoc

[03] - MAIN BOARD MOMIU SCHEMATIC.SchDoc

[04] - INTERFACE BOARD MOMIU SCHEMATIC.SchDoc

Mark Not Fitted Components as

DRAFT - Very early stage of schematic, ignore details.
PRELIMINARY - Close to final schematic.
CHECKED - There should not be any mistakes. Tell the engineer if you find one.
RELEASED - A board with this schematic has been sent to production.

eMOtions stimulated huMan-Interactive aUtomation
embodiment intertation design for reception robot

MOMIU ROBOT-V1 Project.SchDoc
