nuntawat168/MOMIU-Embedded-System/2 - Board Assembly/1-MAIN-BOARD/Mechanical Drawing-PCB-MAIN-BOARD-MOMIU.PDF

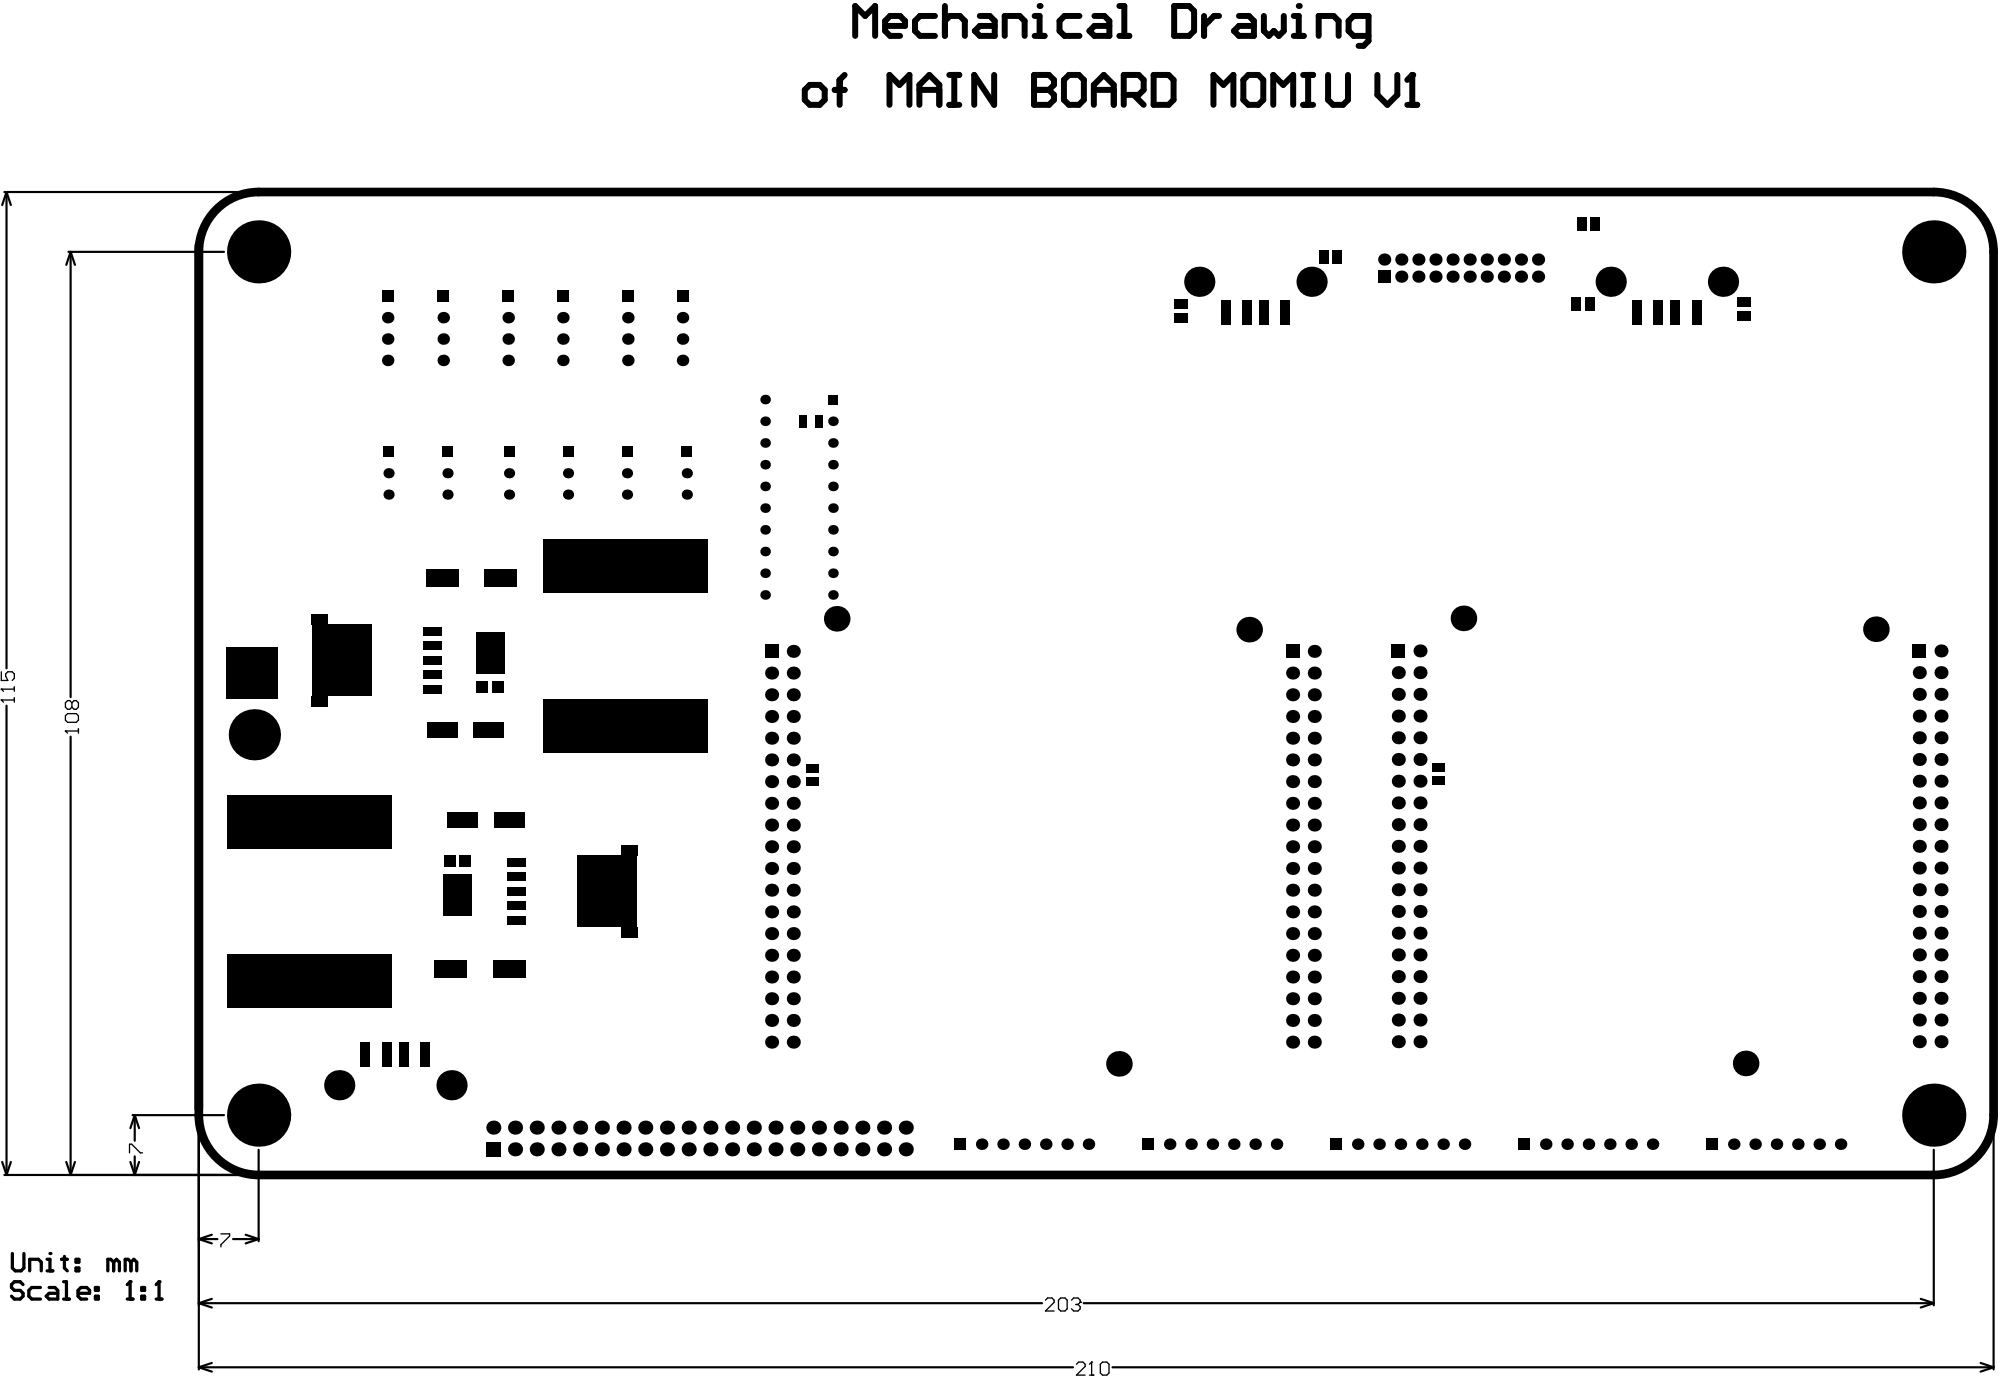
[picture p10: page 1]
