nuntawat168/MOMIU-Embedded-System/2 - Board Assembly/2-INTERFACE-BOARD/Mechanical Drawing-PCB-INTERFACE-BOARD-MOMIU.PDF

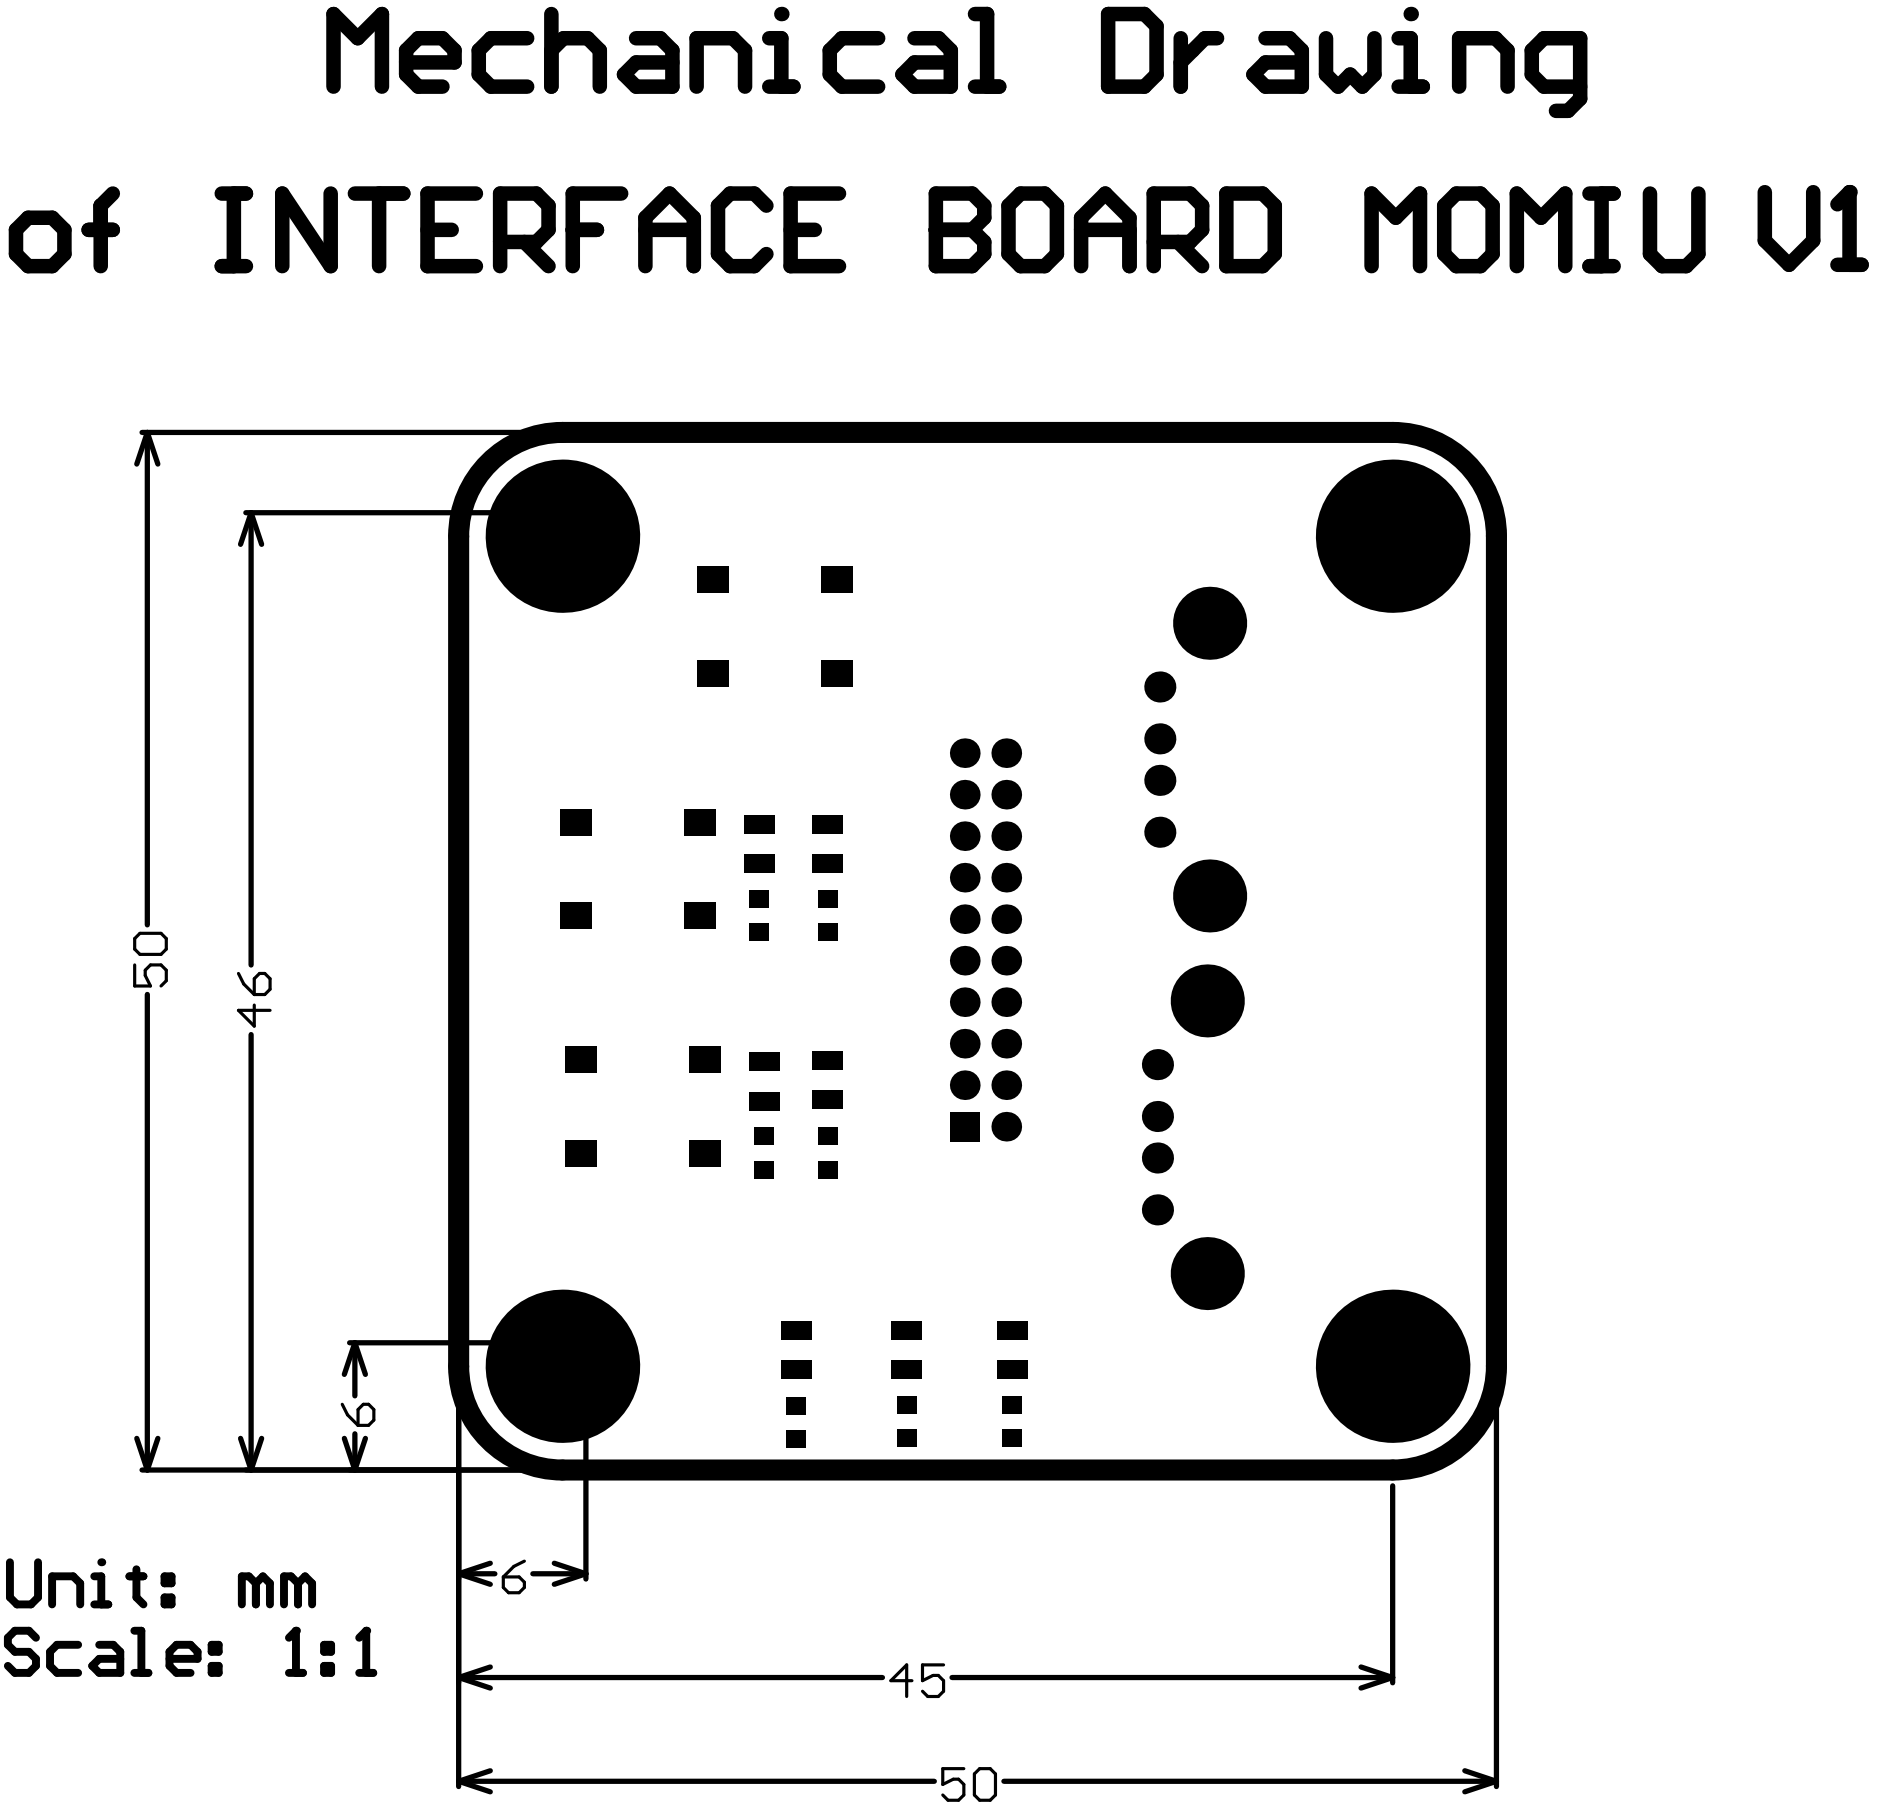
[picture p11: page 1]
