nuntawat168/MOMIU-Embedded-System/(list of files, drawings)

Other design files:
6 - Source Files/[03] - MAIN BOARD MOMIU SCHEMATIC.SchDoc
6 - Source Files/momiu_01.PrjPcb
6 - Source Files/MyPcbLib.PcbLib
