nuntawat168/MOMIU-Embedded-System/3 - Firmware/momiu_mcu_no2/Core/Inc/main.h

#define B1_Pin GPIO_PIN_13
#define B1_GPIO_Port GPIOC
#define XSHUT_VL53L0x_chin_Pin GPIO_PIN_0
#define XSHUT_VL53L0x_chin_GPIO_Port GPIOC
#define XSHUT_VL53L0x_forehead_Pin GPIO_PIN_1
#define XSHUT_VL53L0x_forehead_GPIO_Port GPIOC
#define USART_TX_Pin GPIO_PIN_2
#define USART_TX_GPIO_Port GPIOA
#define USART_RX_Pin GPIO_PIN_3
#define USART_RX_GPIO_Port GPIOA
#define LD2_Pin GPIO_PIN_5
#define LD2_GPIO_Port GPIOA
#define TMS_Pin GPIO_PIN_13
#define TMS_GPIO_Port GPIOA
#define TCK_Pin GPIO_PIN_14
#define TCK_GPIO_Port GPIOA
#define SWO_Pin GPIO_PIN_3
#define SWO_GPIO_Port GPIOB
