nuntawat168/MOMIU-Embedded-System/3 - Firmware/momiu_mcu_no2/Core/Inc/mainpp.h

/*
 * mainpp.h
 *
 *  Created on: Jun 23, 2021
 *      Author: HP
 */

#ifndef INC_MAINPP_H_
#define INC_MAINPP_H_

#ifdef __cplusplus
 extern "C" {
#endif

void setup(void);
void loop(void);

#ifdef __cplusplus
}
#endif



#endif /* INC_MAINPP_H_ */
