nuntawat168/MOMIU-Embedded-System/3 - Firmware/momiu_mcu_no2/Core/Inc/ROS-lib/momiu_msg/IR_message.h

#ifndef _ROS_momiu_p_IR_message_h
#define _ROS_momiu_p_IR_message_h

#include <stdint.h>
#include <string.h>
#include <stdlib.h>
#include "ros/msg.h"

namespace momiu_p
{

  class IR_message : public ros::Msg
  {
    public:
      typedef uint8_t _position_type;
      _position_type position;
      typedef float _range_type;
      _range_type range;

    IR_message():
      position(0),
      range(0)
    {
    }

    virtual int serialize(unsigned char *outbuffer) const override
    {
      int offset = 0;
      *(outbuffer + offset + 0) = (this->position >> (8 * 0)) & 0xFF;
      offset += sizeof(this->position);
      union {
        float real;
        uint32_t base;
      } u_range;
      u_range.real = this->range;
      *(outbuffer + offset + 0) = (u_range.base >> (8 * 0)) & 0xFF;
      *(outbuffer + offset + 1) = (u_range.base >> (8 * 1)) & 0xFF;
      *(outbuffer + offset + 2) = (u_range.base >> (8 * 2)) & 0xFF;
      *(outbuffer + offset + 3) = (u_range.base >> (8 * 3)) & 0xFF;
      offset += sizeof(this->range);
      return offset;
    }

    virtual int deserialize(unsigned char *inbuffer) override
    {
      int offset = 0;
      this->position =  ((uint8_t) (*(inbuffer + offset)));
      offset += sizeof(this->position);
      union {
        float real;
        uint32_t base;
      } u_range;
      u_range.base = 0;
      u_range.base |= ((uint32_t) (*(inbuffer + offset + 0))) << (8 * 0);
      u_range.base |= ((uint32_t) (*(inbuffer + offset + 1))) << (8 * 1);
      u_range.base |= ((uint32_t) (*(inbuffer + offset + 2))) << (8 * 2);
      u_range.base |= ((uint32_t) (*(inbuffer + offset + 3))) << (8 * 3);
      this->range = u_range.real;
      offset += sizeof(this->range);
     return offset;
    }

    virtual const char * getType() override { return "momiu_p/IR_message"; };
    virtual const char * getMD5() override { return "0bed1236a361b463b16bed58859cd211"; };

  };

}
#endif
