nuntawat168/MOMIU-Embedded-System/3 - Firmware/momiu_mcu_no2/Core/Inc/VL53L0x.h

#ifndef __VL53L0X_H
#define __VL53L0X_H

#ifdef __cplusplus
  extern "C" {
#endif

#include "stm32f4xx_hal.h"
#include "i2c.h"

//#include "Structure.h"
//#include "Algorithm_filter.h"


#define VL_forehead_Enable HAL_GPIO_WritePin(GPIOC,GPIO_PIN_1,(GPIO_PinState)1); //PB2 pull high enable of VL53L0X on the forehead
 #define VL_forehead_Disable HAL_GPIO_WritePin(GPIOC,GPIO_PIN_1,(GPIO_PinState)0); //PB2 of VL53L0X on the forehead is pulled down and disabled

 #define VL_chin_Enable HAL_GPIO_WritePin(GPIOC,GPIO_PIN_0,(GPIO_PinState)1); //The PB1 of the VL53L0X on the chin of MOMIU ROBOT is enabled
 #define VL_chin_Disable HAL_GPIO_WritePin(GPIOC,GPIO_PIN_0,(GPIO_PinState)0); //PB1 of VL53L0X on the chin of MOMIU ROBOT is pulled down and disabled


 //Register operation function
 //#define VL53L0x_add 0x52//0x52 //IIC device address of VL53L0x

#define VL53L0X_REG_IDENTIFICATION_MODEL_ID         0xc0
#define VL53L0X_REG_IDENTIFICATION_REVISION_ID      0xc2
#define VL53L0X_REG_PRE_RANGE_CONFIG_VCSEL_PERIOD   0x50
#define VL53L0X_REG_FINAL_RANGE_CONFIG_VCSEL_PERIOD 0x70
#define VL53L0X_REG_SYSRANGE_START                  0x00
#define VL53L0X_REG_RESULT_INTERRUPT_STATUS         0x13
#define VL53L0X_REG_RESULT_RANGE_STATUS             0x14


struct VL53L0xData {
	uint8_t vtemp[12];
	 uint16_t acnt; //Environmental statistics, laser light intensity
	 uint16_t scnt; //Number of signals
	 uint16_t dist; //distance, the unit mm is the most primitive data
	uint8_t DeviceRangeStatusInternal;

	 uint16_t dist_last; //historical effective value, used to judge

	 uint16_t distValid; //The effective value after the original distance value is extracted
	 uint16_t dist_buff[15]; //Slide window buffer for ranging
	uint16_t distValidFinal;

	float GroundDis;
	float GroundDis_last;

	float Speed;
	float Speed_last;

	 uint16_t distFilted; //distance value after Kalman filter
	 uint16_t distFilted_1;//Post Kalman + first-order low-pass filter

	 uint8_t Flag_OverRange; //Overrange flag bit

 /* uint16_t dist_Original; //Original distance value
	 uint16_t dist_OriginalValid; //The effective value after the original distance value is extracted
	uint16_t dist_OriginalValid_lsat;*/
};

 extern struct VL53L0xData VL53L0x_Bottom; //Data of VL53L0x connected to IIC2 at the bottom



void VL53L0x_init(I2C_HandleTypeDef *hi2c, uint16_t VL53L0x_add);

 //Check if VL53L0x is normal
uint8_t VL53L0x_Check(I2C_HandleTypeDef *hi2c, uint16_t VL53L0x_add);

 //VL53L0x convert once
void VL53L0x_StartConversion(I2C_HandleTypeDef *hi2c, uint16_t VL53L0x_add);

 //VL53L0x reading distance and other data feedback information
void VL53L0x_ReadDistance(I2C_HandleTypeDef *hi2c, struct VL53L0xData *VL_temp, uint16_t VL53L0x_add);

void VL53L0x_DataFitting(void);
#ifdef __cplusplus
  }
#endif
#endif
